lycarter/speakez/png/female no mask.jpg

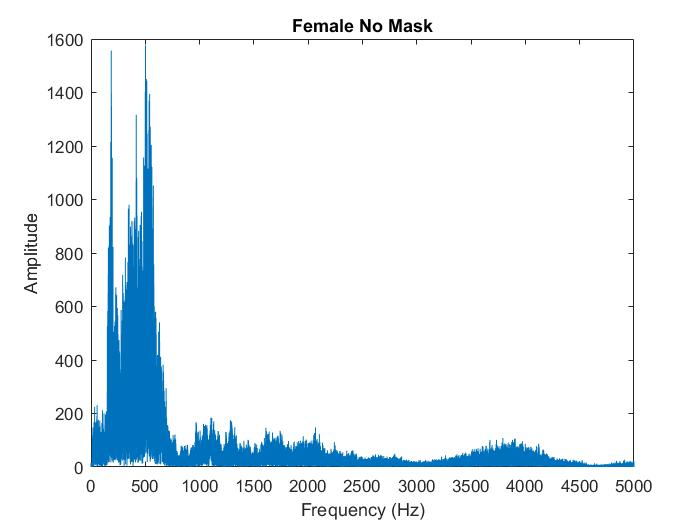
png/female no mask.jpg
