lycarter/speakez/png/female with mask.jpg

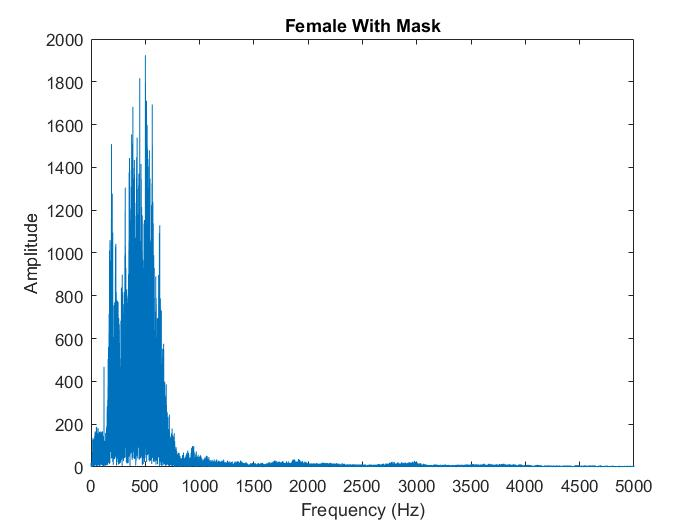
png/female with mask.jpg
