lycarter/speakez/png/fft_comparison.png

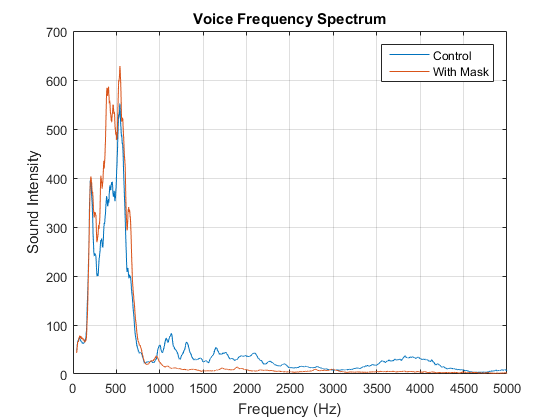
png/fft_comparison.png
