lycarter/speakez/png/fft_comparison_pretty.png

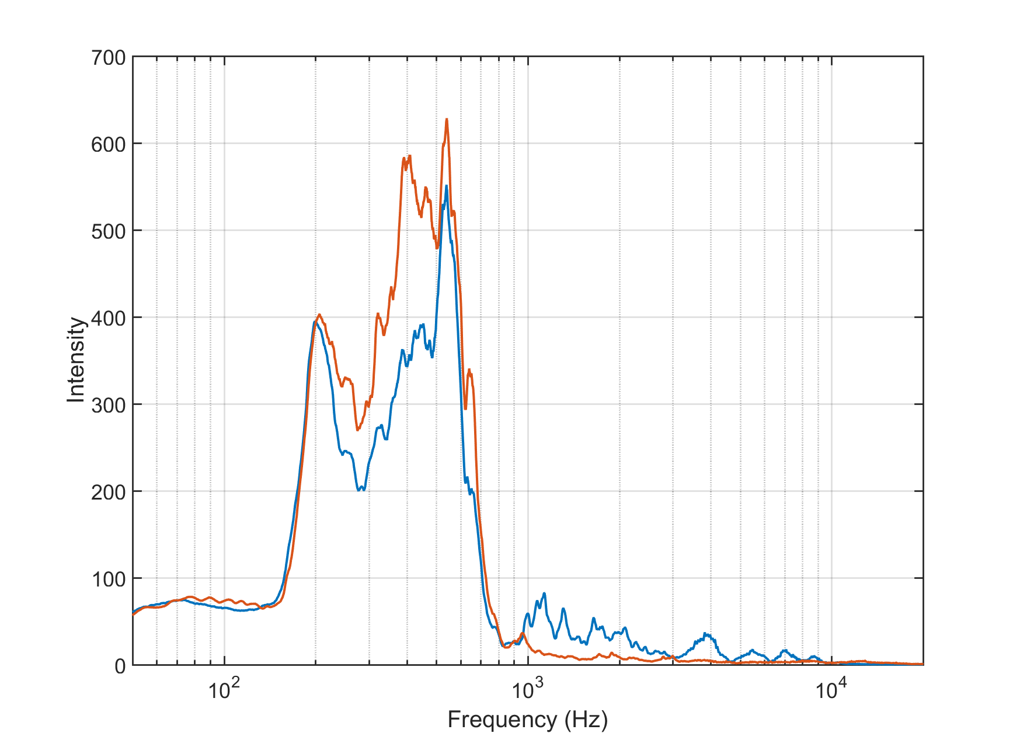
png/fft_comparison_pretty.png
