lycarter/speakez/png/fft_logcompare.png

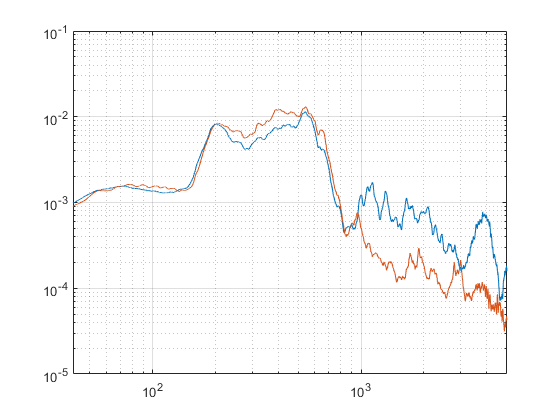
png/fft_logcompare.png
