lycarter/speakez/png/hifreq_output.png

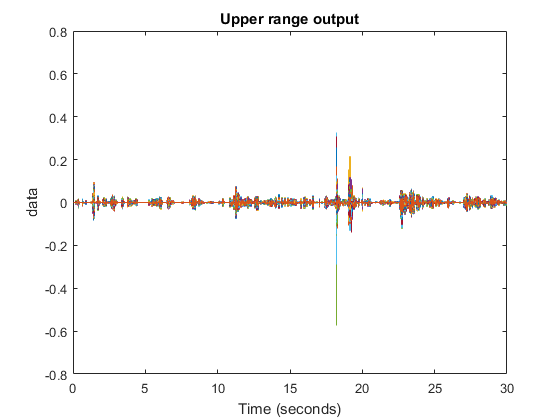
png/hifreq_output.png
