lycarter/speakez/png/input.png

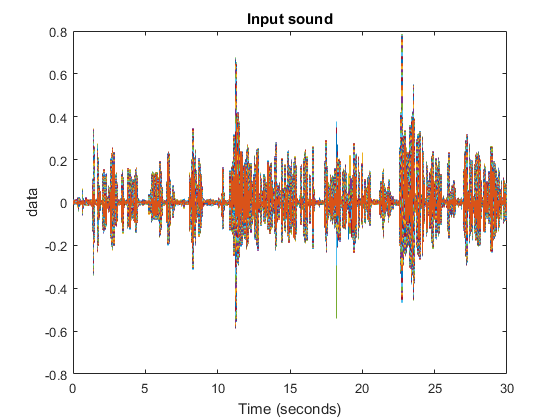
png/input.png
