lycarter/speakez/png/lofreq_output.png

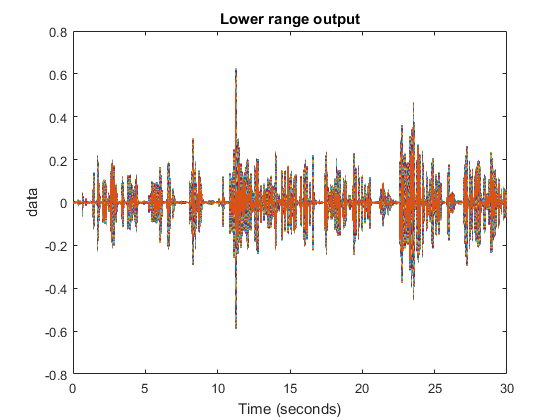
png/lofreq_output.png
