lycarter/speakez/png/mask_tf.png

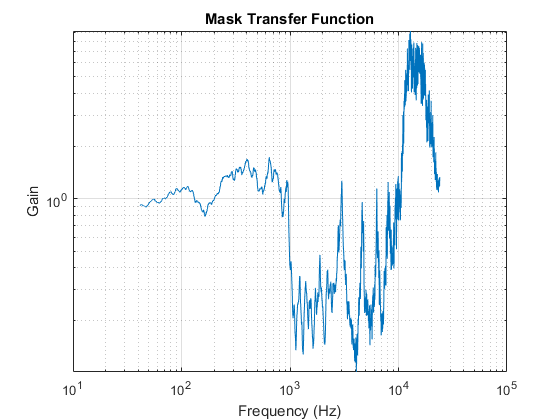
png/mask_tf.png
