lycarter/speakez/png/mask_tf_pretty.png

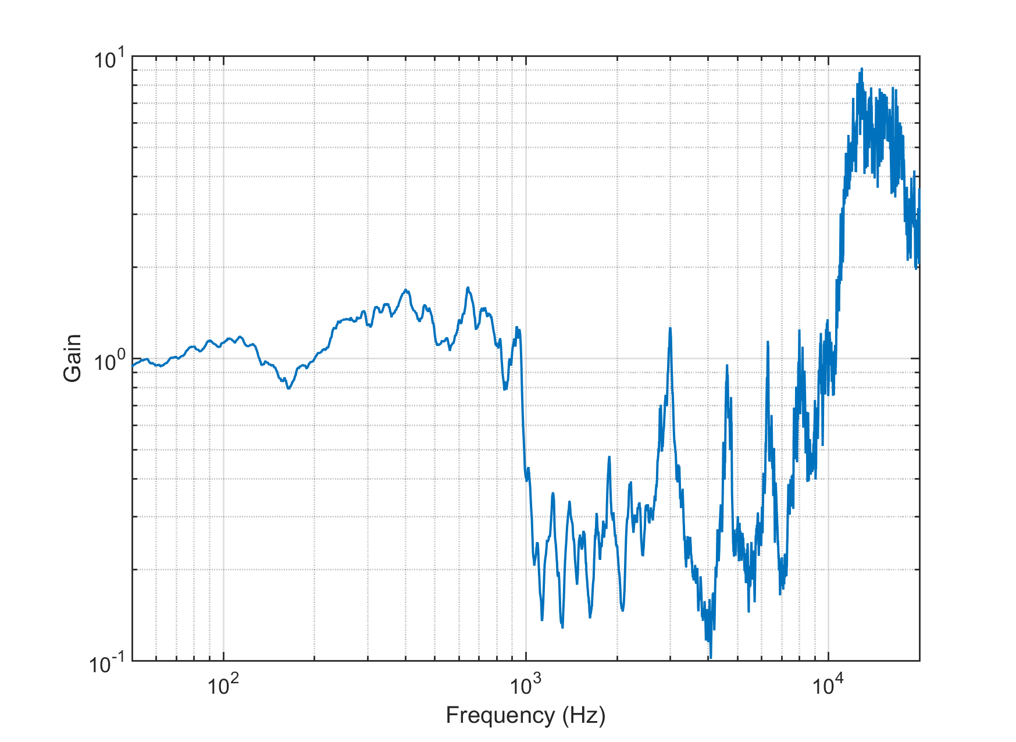
png/mask_tf_pretty.png
