lycarter/speakez/png/no mask divided by mask.jpg

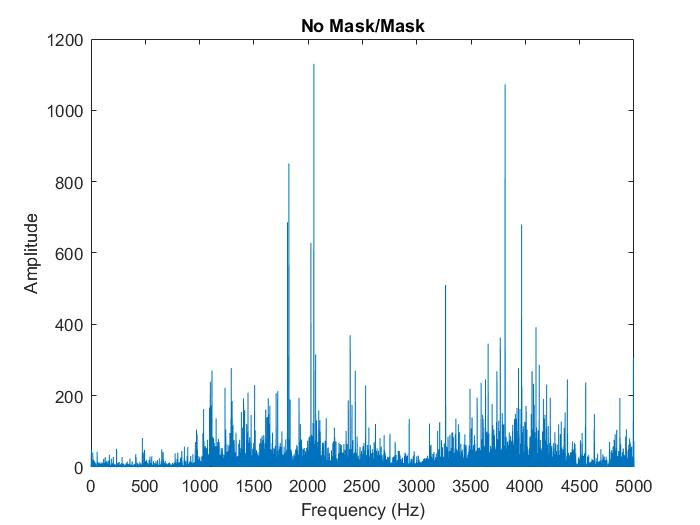
png/no mask divided by mask.jpg
