lycarter/speakez/eagle/speakez/analog-only/analog_v10.brd

## EAGLE design eagle/speakez/analog-only/analog_v10.brd (2016-12-03)

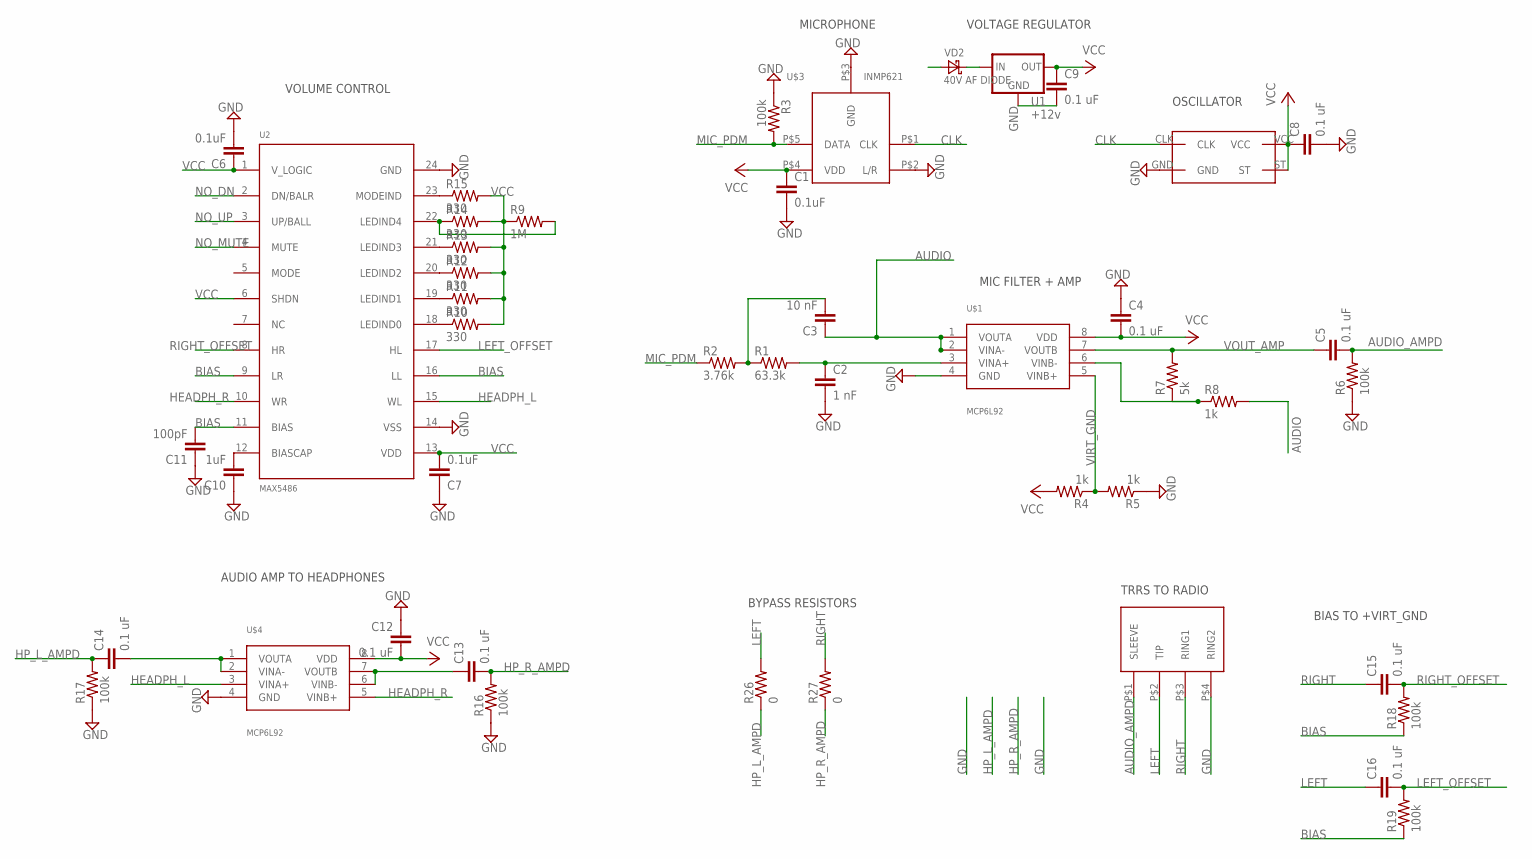
[picture p12: schematic analog_v10.sch]

Parts:
C1, C6, C7: 0.1uF; 0805
C2: 1 nF; 0805
C3: 10 nF; 0805
C4, C5, C8, C9, C12, C13, C14, C15, C16: 0.1 uF; 0805
C10: 1uF; 0805
C11: 100pF; 0805
R1: 63.3k; 0805
R2: 3.76k; 0805
R3, R6, R16, R17, R18, R19: 100k; 0805
R4, R5, R8: 1k; 0805
R7: 5k; 0805
R9: 1M; 0805
R10, R11, R12, R13, R14, R15: 330; 0805
R26, R27: 0; 0805
RADIO: SJ-43514-SMT; 35MM_SMD_4WIRE
U1: +12v; TO-252
U2: MAX5486; TSSOP24
U$1, U$4: MCP6L92; MSOP8
U$2: SG-210STF
U$3: INMP621; CUSTOM_MIC
VD2: 40V AF DIODE; SOD123

Connections:
AUDIO: C3.1, R8.2, U$1.1 (VOUTA), U$1.2 (VINA-)
AUDIO_AMPD: C5.2, R6.2, RADIO.P$1 (SLEEVE)
BIAS: C11.2, R18.1, R19.1, U2.9 (LR), U2.11 (BIAS), U2.16 (LL)
CLK: U$2.CLK, U$3.P$1 (CLK)
GND: C1.2, C2.2, C4.1, C6.2, C7.1, C8.2, C9.2, C10.1, C11.1, C12.1, R3.1, R5.1, R6.1, R16.1, R17.1, RADIO.P$4 (RING2), U1.3 (GND), U2.14 (VSS), U2.24 (GND), U$1.4 (GND), U$2.GND, U$3.P$2 (L/R), U$3.P$3 (GND), U$4.4 (GND)
HEADPH_L: U2.15 (WL), U$4.3 (VINA+)
HEADPH_R: U2.10 (WR), U$4.5 (VINB+)
HP_L_AMPD: C14.1, R17.2, R26.1
HP_R_AMPD: C13.2, R16.2, R27.1
LEFT: C16.1, R26.2, RADIO.P$2 (TIP)
LEFT_OFFSET: C16.2, R19.2, U2.17 (HL)
MIC_PDM: R2.1, R3.2, U$3.P$5 (DATA)
unnamed: C2.1, R1.2, U$1.3 (VINA+)
unnamed: C3.2, R1.1, R2.2
unnamed: R10.1, U2.18 (LEDIND0)
unnamed: R11.1, U2.19 (LEDIND1)
unnamed: R7.1, R8.1, U$1.6 (VINB-)
unnamed: R12.1, U2.20 (LEDIND2)
unnamed: R13.1, U2.21 (LEDIND3)
unnamed: C13.1, U$4.6 (VINB-), U$4.7 (VOUTB)
unnamed: R15.1, U2.23 (MODEIND)
unnamed: C10.2, U2.12 (BIASCAP)
unnamed: R9.2, R14.1, U2.22 (LEDIND4)
unnamed: C14.2, U$4.1 (VOUTA), U$4.2 (VINA-)
NO_DN: U2.2 (DN/BALR)
NO_MUTE: U2.4 (MUTE)
NO_UP: U2.3 (UP/BALL)
RIGHT: C15.1, R27.2, RADIO.P$3 (RING1)
RIGHT_OFFSET: C15.2, R18.2, U2.8 (HR)
VBAT: VD2.A
VBATSAFE: U1.2 (IN), VD2.C
VCC: C1.1, C4.2, C6.1, C7.2, C8.1, C9.1, C12.2, R4.2, R9.1, R10.2, R11.2, R12.2, R13.2, R14.2, R15.2, U1.1 (OUT), U2.1 (V_LOGIC), U2.6 (SHDN), U2.13 (VDD), U$1.8 (VDD), U$2.ST, U$2.VCC, U$3.P$4 (VDD), U$4.8 (VDD)
VIRT_GND: R4.1, R5.2, U$1.5 (VINB+)
VOUT_AMP: C5.1, R7.2, U$1.7 (VOUTB)

Notes on the sheet:
TRRS TO RADIO
BYPASS RESISTORS
AUDIO AMP TO HEADPHONES
VOLUME CONTROL
MIC FILTER + AMP
OSCILLATOR
MICROPHONE
VOLTAGE REGULATOR
BIAS TO +VIRT_GND

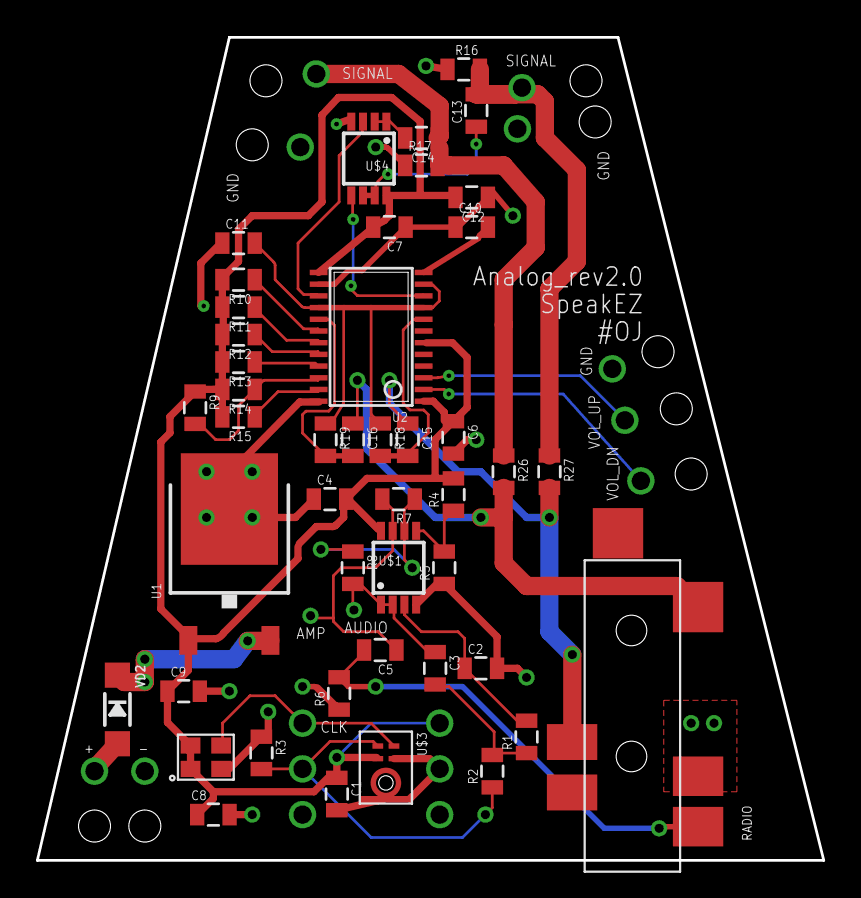
[picture p13: board analog_v10.brd from above]

Board: 2 copper layers, 43.7 x 45.7 mm, 45 parts (0 on the bottom side), 30 nets.
