lycarter/speakez/eagle/speakez/mainboard.brd

## EAGLE design eagle/speakez/mainboard.brd (2016-11-14)

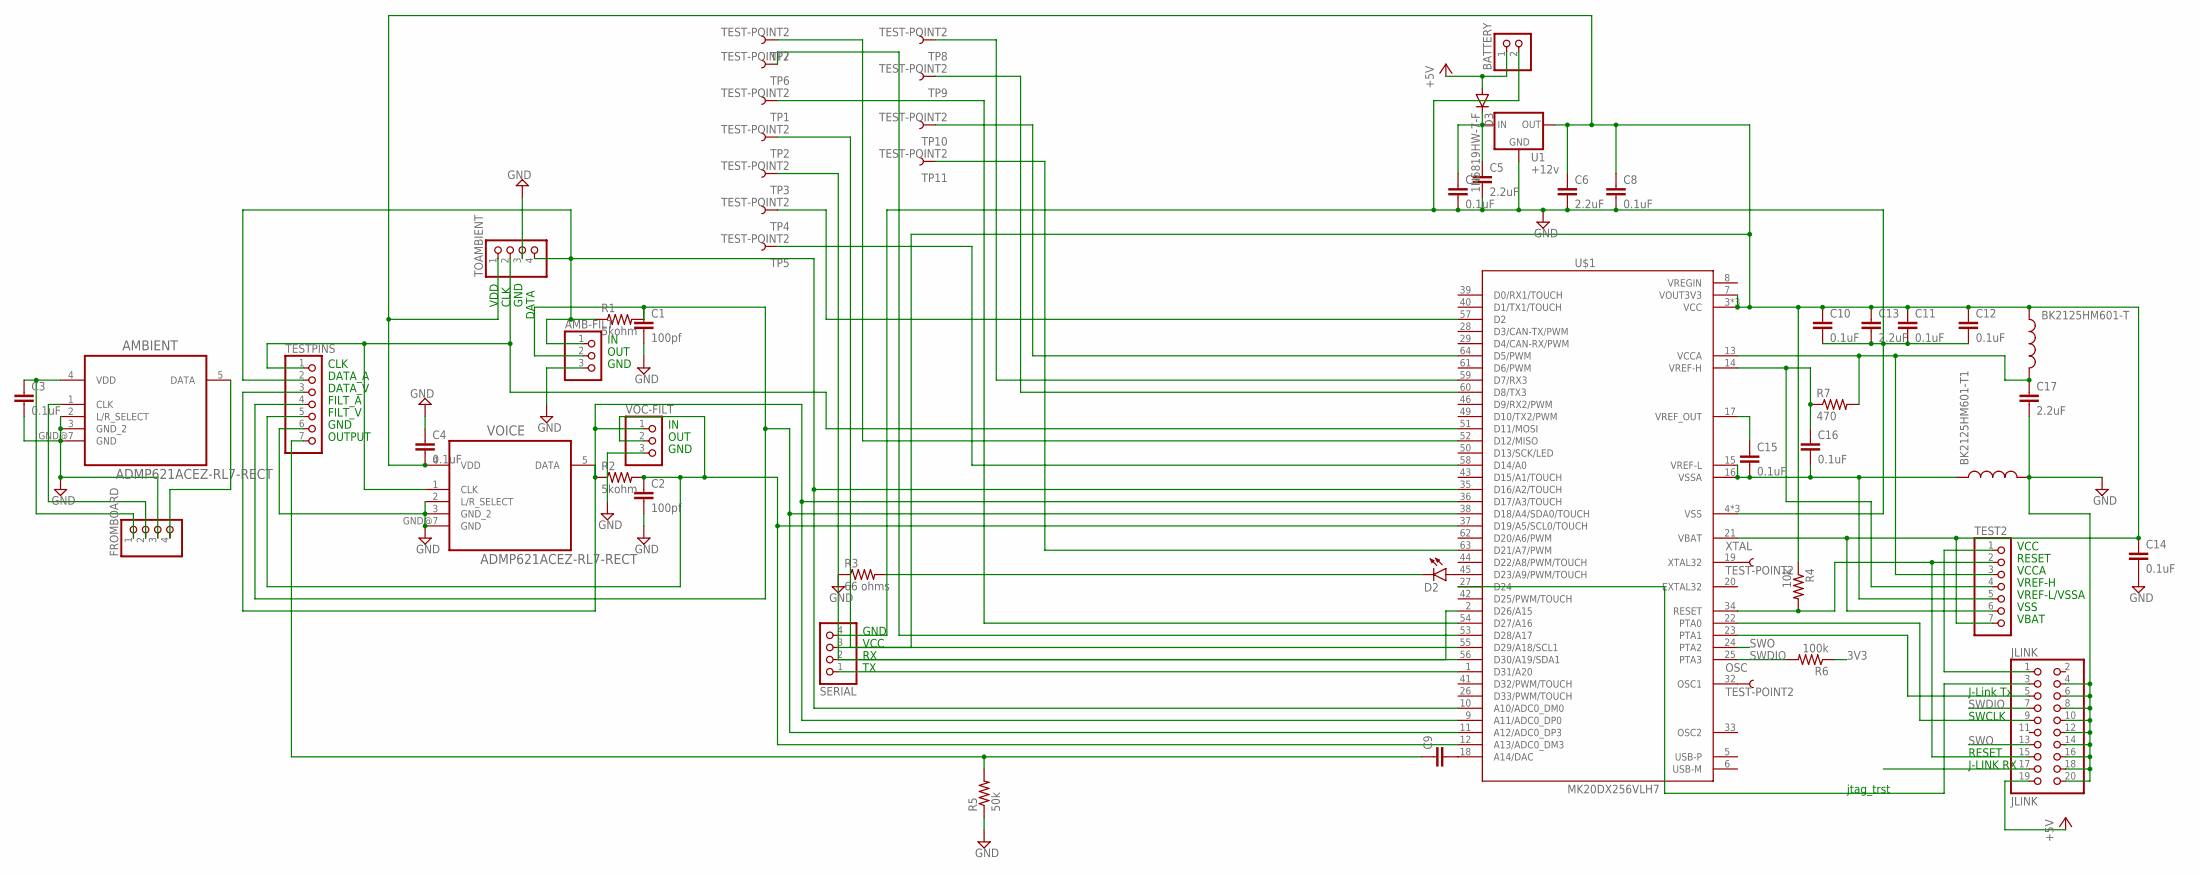
[picture p14: schematic mainboard.sch]

Parts:
AMB-FILT: PINHD-1X3; 1X03
AMBIENT: ADMP621ACEZ-RL7-RECT
BATTERY: PINHD-1X2; 1X02
BK2125HM601-T, BK2125HM601-T1: INDUCTOR0805; 0805
C1, C2: 100pf; 0805
C3, C4, C7, C8, C10, C11, C12, C14, C15, C16: 0.1uF; 0805
C5, C6, C13, C17: 2.2uF; 0805
C9: CAP0805; 0805
D2: LED1206; LED-1206
D3: 1N5819HW-7-F; SOD-123
FROMBOARD: PINHD-1X4; 1X04
JLINK: JLINK; 2X10
OSC: TEST-POINT2; PAD.02X.02
R1, R2: 5kohm; 0805
R3: 66 ohms; 0805
R4: 10k; 0805
R5: 50k; 0805
R6: 100k; 0805
R7: 470; 0805
SERIAL: PINHD-1X4; 1X04
TEST2: PINHD-1X7; 1X07
TESTPINS: PINHD-1X7; 1X07
TOAMBIENT: PINHD-1X4M; 1X04M
TP1, TP2, TP3, TP4, TP5, TP6, TP7, TP8, TP9, TP10, TP11: TEST-POINT2; PAD.02X.02
U1: +12v; TO-252
U$1: MK20DX256VLH7; QFP50P1200X1200X160-64N
VOC-FILT: PINHD-1X3; 1X03
VOICE: ADMP621ACEZ-RL7-RECT
XTAL: TEST-POINT2; PAD.02X.02

Connections:
3V3: R6.1
+5V: BATTERY.1, D3.A, JLINK.19
CLK: TESTPINS.1, TOAMBIENT.2, U$1.51 (D11/MOSI), VOICE.1 (CLK)
CLK2-A: AMBIENT.1 (CLK), FROMBOARD.2
DATA: R2.1, TESTPINS.3, U$1.9 (A11/ADC0_DP0), U$1.36 (D17/A3/TOUCH), VOC-FILT.1, VOICE.5 (DATA)
DATA2: AMB-FILT.1, R1.1, TESTPINS.2, TOAMBIENT.4, U$1.10 (A10/ADC0_DM0), U$1.35 (D16/A2/TOUCH)
DATA2-A: AMBIENT.5 (DATA), FROMBOARD.4
GND: AMB-FILT.3, AMBIENT.2 (L/R_SELECT), AMBIENT.3 (GND_2), AMBIENT.GND@7 (GND), BATTERY.2, BK2125HM601-T1.2, C1.2, C2.2, C3.2, C4.1, C5.2, C6.2, C7.2, C8.2, C10.2, C11.2, C12.2, C13.2, C14.2, C17.2, FROMBOARD.3, JLINK.4, JLINK.6, JLINK.8, JLINK.10, JLINK.12, JLINK.14, JLINK.16, JLINK.18, JLINK.20, R3.1, R5.1, SERIAL.4, TESTPINS.6, TOAMBIENT.3, U1.3 (GND), U$1.4 (VSS), U$1.31 (VSS), U$1.47 (VSS), VOC-FILT.3, VOICE.2 (L/R_SELECT), VOICE.3 (GND_2), VOICE.GND@7 (GND)
JTAG_TRST: JLINK.3, U$1.27 (D24)
unnamed: AMB-FILT.2, C1.1, R1.2, TESTPINS.4, U$1.11 (A12/ADC0_DP3), U$1.38 (D18/A4/SDA0/TOUCH)
unnamed: C2.1, R2.2, TESTPINS.5, U$1.12 (A13/ADC0_DM3), U$1.37 (D19/A5/SCL0/TOUCH), VOC-FILT.2
unnamed: TP7.P$1, U$1.52 (D12/MISO)
unnamed: TP6.P$1, U$1.53 (D28/A17)
unnamed: TP1.P$1, U$1.54 (D27/A16)
unnamed: TP2.P$1, U$1.55 (D29/A18/SCL1)
unnamed: TP3.P$1, U$1.56 (D30/A19/SDA1)
unnamed: TP4.P$1, U$1.57 (D2)
unnamed: TP5.P$1, U$1.58 (D14/A0)
unnamed: TP8.P$1, U$1.59 (D7/RX3)
unnamed: TP9.P$1, U$1.60 (D8/TX3)
unnamed: JLINK.5, U$1.23 (PTA1)
unnamed: JLINK.9, U$1.22 (PTA0)
unnamed: C5.1, C7.1, D3.C, U1.2 (IN)
unnamed: JLINK.1, TEST2.1
unnamed: D2.A, U$1.45 (D23/A9/PWM/TOUCH)
unnamed: TP10.P$1, U$1.64 (D5/PWM)
unnamed: D2.C, R3.2
unnamed: BK2125HM601-T1.1, C15.2, C16.2, TEST2.5, U$1.15 (VREF-L), U$1.16 (VSSA)
unnamed: TP11.P$1, U$1.63 (D21/A7/PWM)
unnamed: C16.1, R7.1, TEST2.4, U$1.14 (VREF-H)
unnamed: U$1.19 (XTAL32), XTAL.P$1
unnamed: SERIAL.1, U$1.1 (D31/A20)
unnamed: SERIAL.2, U$1.2 (D26/A15)
unnamed: C9.2, U$1.18 (A14/DAC)
unnamed: C9.1, R5.2, TESTPINS.7
unnamed: OSC.P$1, U$1.32 (OSC1)
unnamed: BK2125HM601-T.2, C17.1, R7.2, TEST2.3, U$1.13 (VCCA)
unnamed: C15.1, U$1.17 (VREF_OUT)
RESET: JLINK.15, R4.2, TEST2.2, U$1.34 (RESET)
SWDIO: JLINK.7, R6.2, U$1.25 (PTA3)
SWO: JLINK.13, U$1.24 (PTA2)
VDD-DECOUP: BK2125HM601-T.1, C4.2, C6.1, C8.1, C10.1, C11.1, C12.1, C13.1, C14.1, R4.1, SERIAL.3, TEST2.6, TEST2.7, TOAMBIENT.1, U1.1 (OUT), U$1.3 (VCC), U$1.7 (VOUT3V3), U$1.21 (VBAT), U$1.30 (VCC), U$1.48 (VCC), VOICE.4 (VDD)
VDD-DECOUP-A: AMBIENT.4 (VDD), C3.1, FROMBOARD.1

Notes on the sheet:
VDD
DATA
GND
CLK
VCC
DATA_A
DATA_V
FILT_A
FILT_V
OUTPUT
RESET
VCCA
VREF-H
VREF-L/VSSA
VBAT
VSS
J-Link Tx
SWCLK
J-LINK RX
jtag_trst
OUT

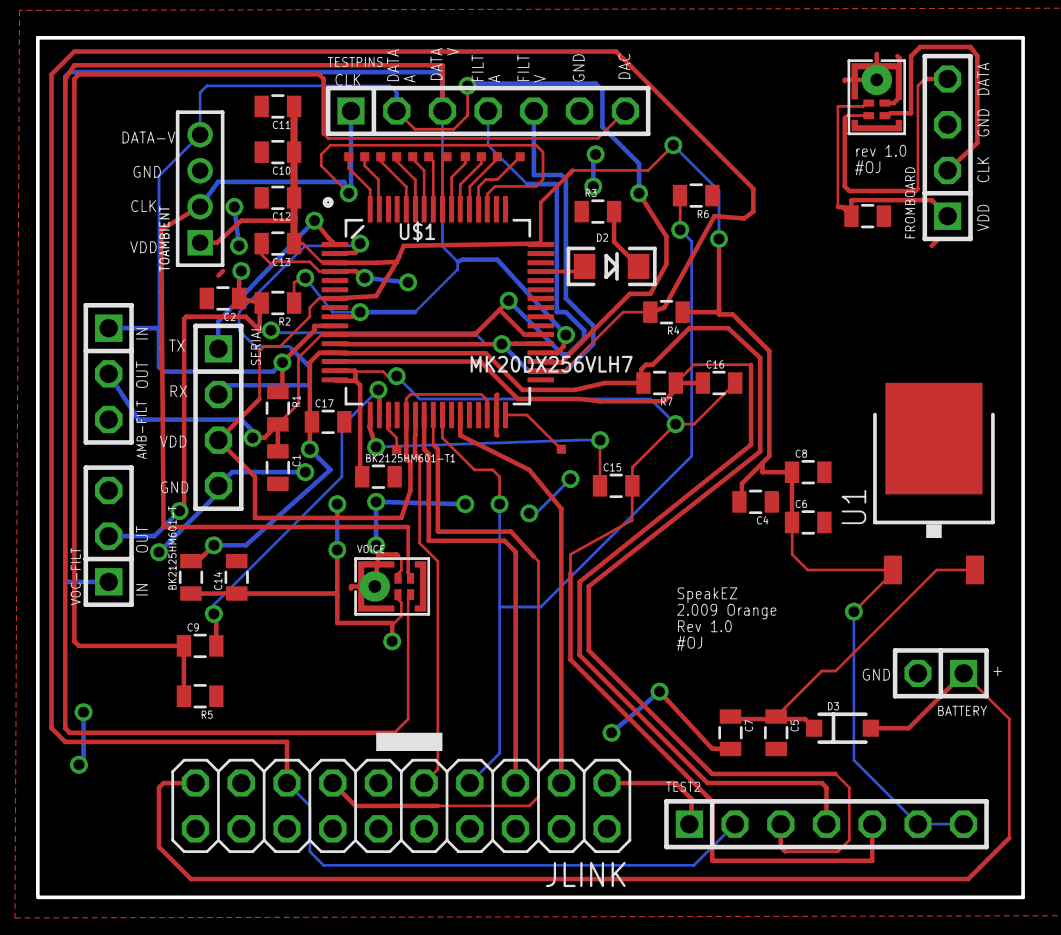
[picture p15: board mainboard.brd from above]

Board: 2 copper layers, 54.7 x 47.8 mm, 54 parts (0 on the bottom side), 42 nets.
