lycarter/speakez/eagle/Custom-Teensy-master/Custom_Teensy_3.1.brd

## EAGLE design eagle/Custom-Teensy-master/Custom_Teensy_3.1.brd (2016-11-14)

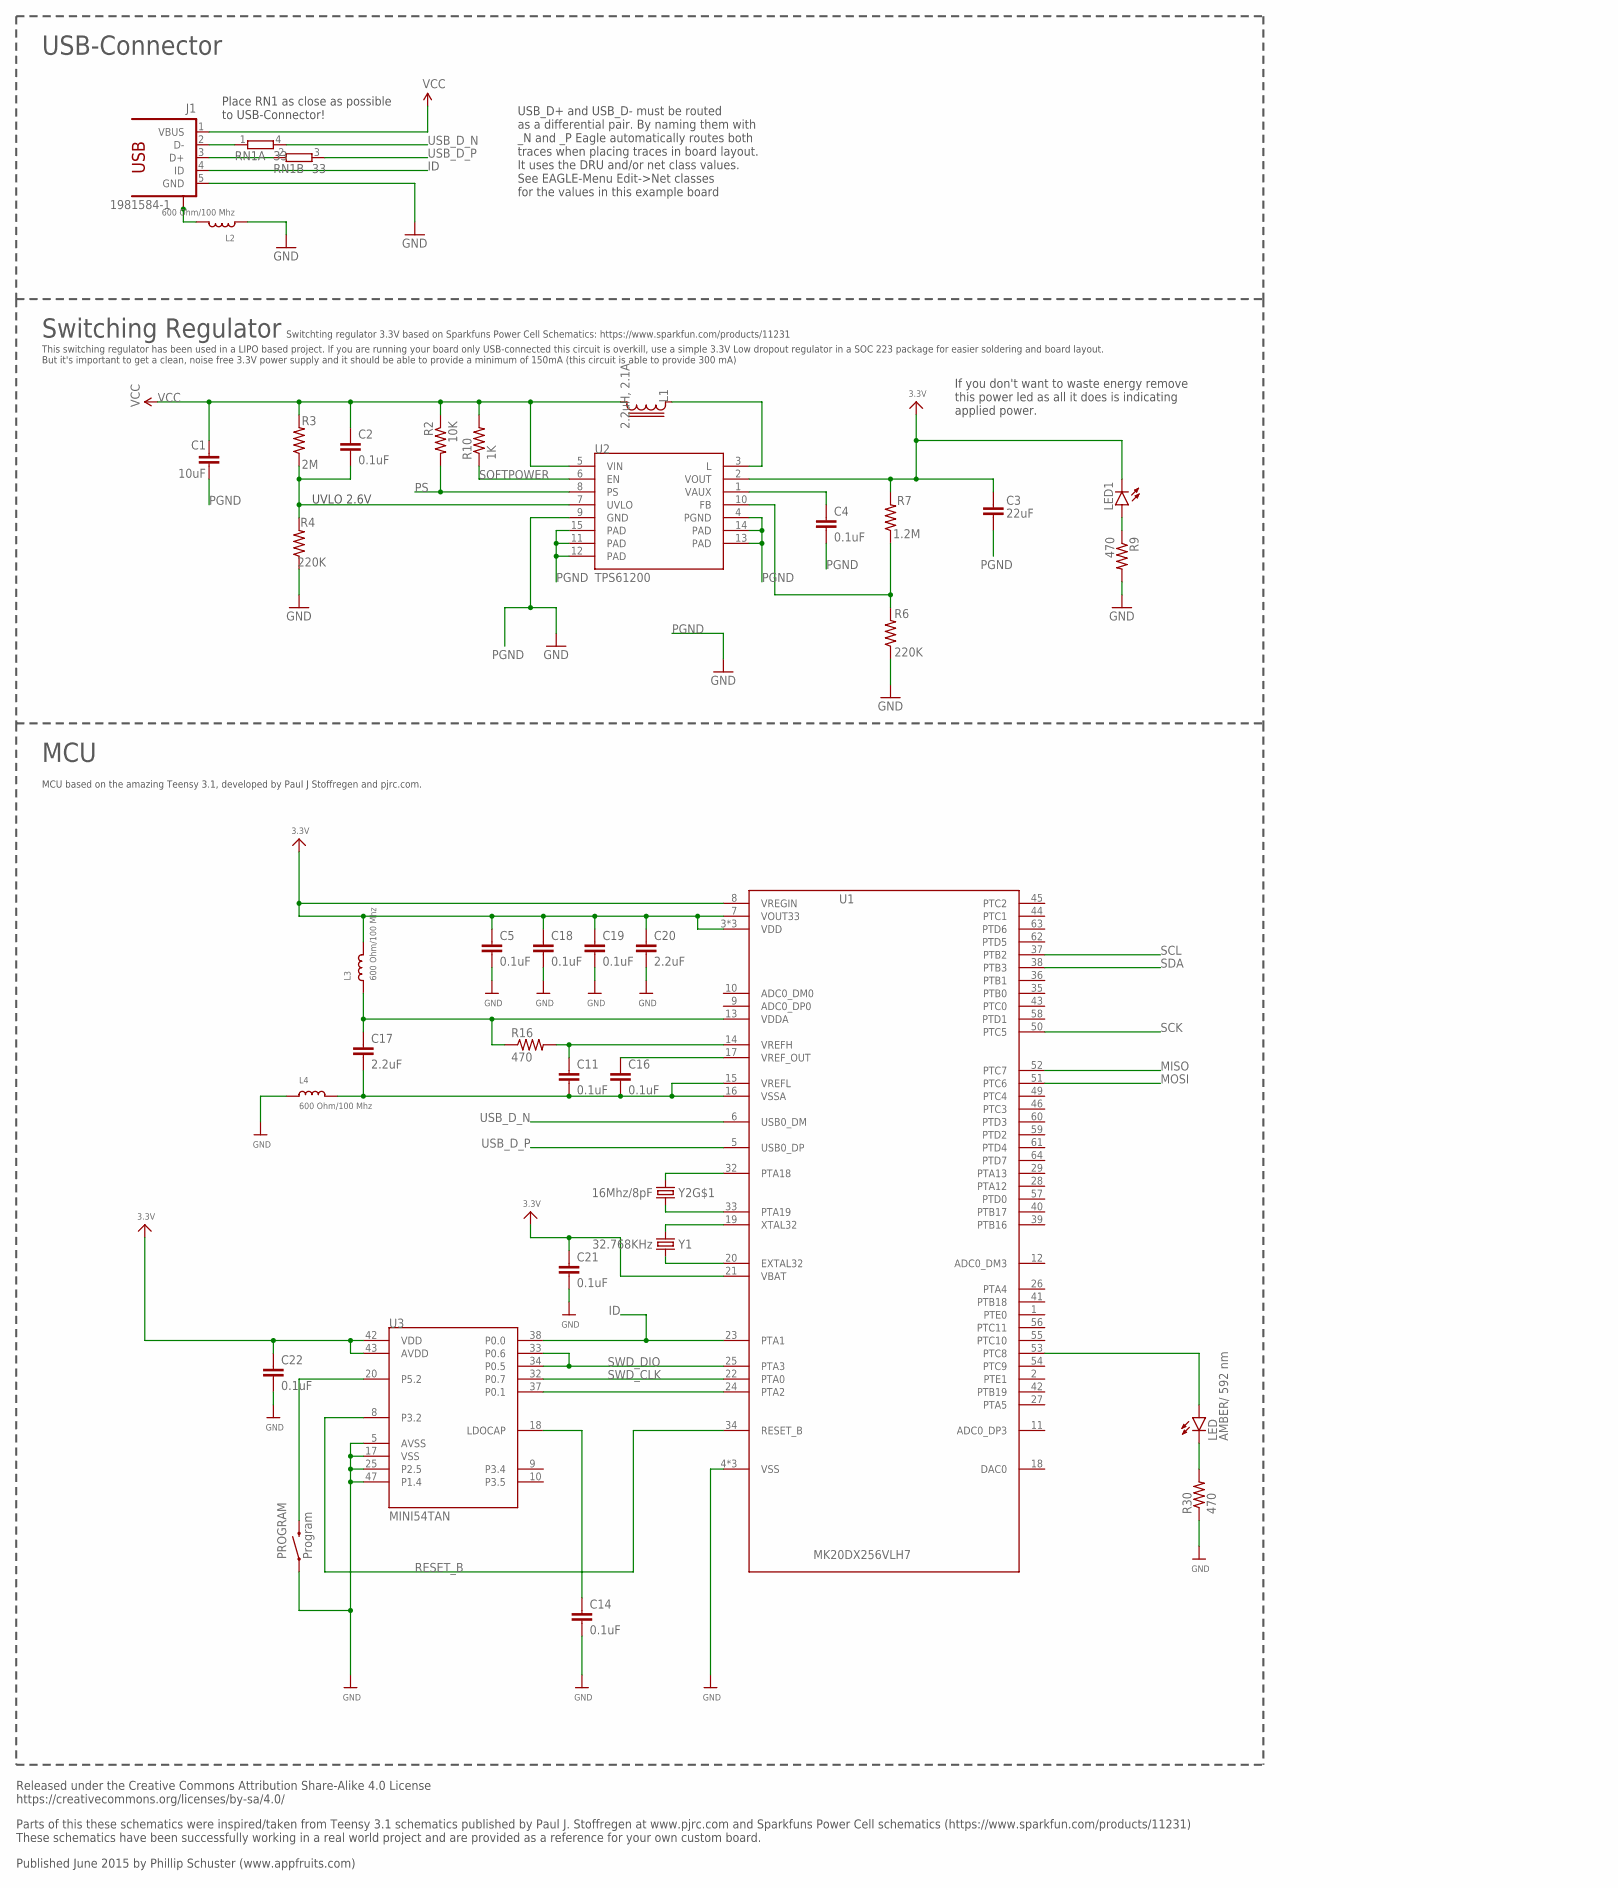
[picture p16: schematic Custom_Teensy_3.1.sch]

Parts:
C1: 10uF; 0603-CAP
C2, C4, C5, C11, C14, C16, C18, C19, C21, C22: 0.1uF; 0603-CAP
C3: 22uF; 0603-CAP
C17, C20: 2.2uF; 0603-CAP
J1: 1981584-1; MPN ZX62-AB-5PA(11)
L1: 2.2uH, 2.1A; LPS3015
L2, L3, L4: 600 Ohm/100 Mhz; 0805
LED: AMBER/ 592 nm; LED-0603
LED1: LED-GREEN; LED-0603
PROGRAM: Program; TACTILE-SWITCH-1101NE; MPN RS-282G05A3-SM RT
R2: 10K; 0603-RES
R3: 2M; 0603-RES
R4, R6: 220K; 0603-RES
R7: 1.2M; 0603-RES
R9, R16, R30: 470; 0603-RES
R10: 1K; 0603-RES
RN1: 33; EXB34V; MPN EXB-34V330JV
U1: MK20DX256VLH7; MPN MK20DX256VLH7
U2: TPS61200; QFN-10_PAD
U3: MINI54TAN
Y1: 32.768KHz; CRYSTAL-TXC-7A; MPN FC-255 32.7680K-A3
Y2: 16Mhz/8pF; CRYSTAL-SMD-5X3; MPN ECS-160-8-30B-CKM

Connections:
3.3V: C3.1, C5.1, C18.1, C19.1, C20.1, C21.1, C22.1, L3.2, LED1.C, R7.2, U1.3 (VDD), U1.7 (VOUT33), U1.8 (VREGIN), U1.21 (VBAT), U1.30 (VDD), U1.48 (VDD), U2.2 (VOUT), U3.42 (VDD), U3.43 (AVDD)
FB: R6.2, R7.1, U2.10 (FB)
GND: C5.2, C14.2, C18.2, C19.2, C20.2, C21.2, C22.2, J1.5 (GND), L2.1, L4.1, PROGRAM.P$1 (1), R4.1, R6.1, R9.2, R30.1, U1.4 (VSS), U1.31 (VSS), U1.47 (VSS), U3.5 (AVSS), U3.17 (VSS), U3.25 (P2.5), U3.47 (P1.4)
ID: J1.4 (ID), U1.23 (PTA1), U3.38 (P0.0)
MISO: U1.52 (PTC7)
MOSI: U1.51 (PTC6)
unnamed: LED1.A, R9.1
unnamed: L1.1, U2.3 (L)
unnamed: LED.A, U1.53 (PTC8)
unnamed: U1.24 (PTA2), U3.37 (P0.1)
unnamed: LED.C, R30.2
unnamed: PROGRAM.P$2 (2), U3.20 (P5.2)
unnamed: C14.1, U3.18 (LDOCAP)
unnamed: U1.32 (PTA18), Y2.3 (2)
unnamed: U1.33 (PTA19), Y2.1
unnamed: U1.19 (XTAL32), Y1.P$2 (2)
unnamed: U1.20 (EXTAL32), Y1.P$1 (1)
PGND: C1.2, C3.2, C4.2, U2.4 (PGND), U2.9 (GND), U2.11 (PAD), U2.12 (PAD), U2.13 (PAD), U2.14 (PAD), U2.15 (PAD)
PS: R2.2, U2.8 (PS)
RESET_B: U1.34 (RESET_B), U3.8 (P3.2)
SCK: U1.50 (PTC5)
SCL: U1.37 (PTB2)
SDA: U1.38 (PTB3)
SOFTPOWER: R10.1, U2.6 (EN)
SWD_CLK: U1.22 (PTA0), U3.32 (P0.7)
SWD_DIO: U1.25 (PTA3), U3.33 (P0.6), U3.34 (P0.5)
USB_CON_N: J1.2 (D-), RN1.1
USB_CON_P: J1.3 (D+), RN1.2 (1)
USB_D_N: RN1.4 (2), U1.6 (USB0_DM)
USB_D_P: RN1.3 (2), U1.5 (USB0_DP)
USB_SHIELD: J1.S1, J1.S2, J1.S3, J1.S4, L2.2
UVLO: C2.2, R3.1, R4.2, U2.7 (UVLO)
VAUX: C4.1, U2.1 (VAUX)
VCC: C1.1, C2.1, J1.1 (VBUS), L1.2, R2.1, R3.2, R10.2, U2.5 (VIN)
VDDA: C17.1, L3.1, R16.1, U1.13 (VDDA)
VREFH: C11.1, R16.2, U1.14 (VREFH)
VREFL: C11.2, C16.2, C17.2, L4.2, U1.15 (VREFL), U1.16 (VSSA)
VREF_OUT: C16.1, U1.17 (VREF_OUT)

Notes on the sheet:
UVLO 2.6V
USB-Connector
Switching Regulator
MCU
MCU based on the amazing Teensy 3.1, developed by Paul J Stoffregen and pjrc.com.
Place RN1 as close as possible to USB-Connector!
If you don't want to waste energy remove this power led as all it does is indicating applied power.
USB_D+ and USB_D- must be routed as a differential pair. By naming them with _N and _P Eagle automatically routes both traces when placing traces in board layout. It uses the DRU and/or net class values. See EAGLE-Menu Edit->Net classes for the values in this example board
Released under the Creative Commons Attribution Share-Alike 4.0 License https://creativecommons.org/licenses/by-sa/4.0/
Parts of this these schematics were inspired/taken from Teensy 3.1 schematics published by Paul J. Stoffregen at www.pjrc.com and Sparkfuns Power Cell schematics (https://www.sparkfun.com/products/11231) These schematics have been successfully working in a real world project and are provided as a r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
Published June 2015 by Phillip Schuster (www.appfruits.com)
Switchting regulator 3.3V based on Sparkfuns Power Cell Schematics: https://www.sparkfun.com/products/11231
This switching regulator has been used in a LIPO based project. If you are running your board only USB-connected this circuit is overkill, use a simple 3.3V Low dropout regulator in a SOC 223 package for easier soldering and board layout. But it's important to get a clean, noise free 3.3V power sup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

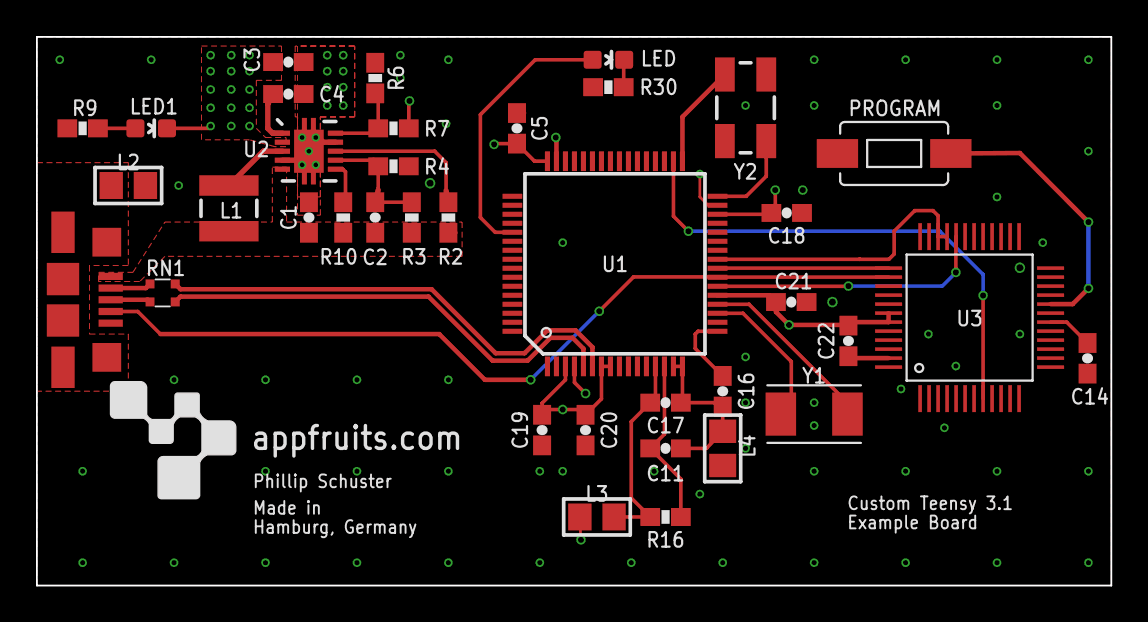
[picture p17: board Custom_Teensy_3.1.brd from above]

Board: 4 copper layers, 59.7 x 30.5 mm, 37 parts (0 on the bottom side), 33 nets.
