lycarter/speakez/(commit log)

2016-11-04 initial commit
    files from assembly review
2016-11-05 add eagle project
    empty project/schematic
    [mainboard.sch]
2016-11-05 add rc circuit to schematic
    [mainboard.sch]
2016-11-05 correct capcitor value
    100pf for rc circuit, 0.1uf for decoupling cap
    [mainboard.sch]
2016-11-05 added mics and breakout pins
    added both mics and test pins, also female pins for attaching teensy
    (remove if you were planning to just use a breadboard)
    [mainboard.sch]
2016-11-05 Ribbon cable
    we were going to use a ribbon cable I think? I added headers for that
    [mainboard.sch]
2016-11-06 change mic cap value, add battery header
    Changed mic cap to datasheet recommendation. Added screw terminals for
    battery + diode for protection
    [mainboard.sch]
2016-11-06 Added board
    Added board, still needs to be routed
    [mainboard.brd]
2016-11-06 Added GND to test pins
    [mainboard.brd, mainboard.sch]
2016-11-06 Added decoupling cap
    [mainboard.brd, mainboard.sch]
2016-11-06 Merge remote-tracking branch 'origin/master'
    # Conflicts:
    # eagle/speakez/mainboard.brd
    # eagle/speakez/mainboard.sch
    [mainboard.brd, mainboard.sch]
2016-11-06 added decoupling cap to mic
    also kept clock pin as pin 11
    [mainboard.brd, mainboard.sch]
2016-11-06 remap teensy pins
    move analog inputs to adc pins, switch 3.3v source, gnd source. add clk
    signal to digital output pin
    [mainboard.brd, mainboard.sch]
2016-11-07 Added microcontroller
    [mainboard.brd, mainboard.sch]
2016-11-07 Added battery stuff
    decoupling caps for battery with Fiona
    [mainboard.brd, mainboard.sch]
2016-11-07 Added clock pin
    Still need to connect up headers but I can do that later
    [mainboard.brd, mainboard.sch]
2016-11-07 changed clock
    [mainboard.brd, mainboard.sch]
2016-11-07 disconnected battery from V3v3
    [mainboard.brd, mainboard.sch]
2016-11-07 changed clock pin
    [mainboard.brd, mainboard.sch]
2016-11-07 switched mic in to analog pins
    [mainboard.brd, mainboard.sch]
2016-11-07 added 0.1uF caps
    [mainboard.brd, mainboard.sch]
2016-11-07 re-added the differential pins
    [mainboard.brd, mainboard.sch]
2016-11-07 connect VREFH and VBAT
    [mainboard.brd, mainboard.sch]
2016-11-07 Added test LED
    [mainboard.brd, mainboard.sch]
2016-11-07 added pull-up resistor to RESET
    [mainboard.brd, mainboard.sch]
2016-11-07 added programmer for header
    [mainboard.brd, mainboard.sch]
2016-11-07 added serial header connected to TX/RX
    [mainboard.brd, mainboard.sch]
2016-11-07 added DAC cap + resistor
    didn't choose cap value yet. Sent output to a header test pin
    [mainboard.brd, mainboard.sch]
2016-11-07 test pins for VCC and RESET
    [mainboard.brd, mainboard.sch]
2016-11-07 Custom Teensy
    files from guy who made his own teensy
    [Custom_Teensy_3.1.brd, Custom_Teensy_3.1.csv, Custom_Teensy_3.1.sch]
2016-11-08 Added correct header for programmer
    [mainboard.brd, mainboard.sch]
2016-11-08 added decoupling caps
    to microcontroller VCC pin
    [mainboard.brd, mainboard.sch]
2016-11-08 finished copying over Teensy schematic
    Added a few more caps and ferrite beads to the microcontroller pins. I
    didn't connect VREF-H directly to VBAT. Added test pins.
    [mainboard.brd, mainboard.sch]
2016-11-08 0.05" header to 0.1" header
    [mainboard.brd, mainboard.sch]
2016-11-08 update jlink connector
    also add jtag support
    [mainboard.brd, mainboard.sch]
2016-11-08 started moving things around
    oh god so many passives
    [mainboard.brd]
2016-11-09 added ground rectangle thing
    [mainboard.brd, mainboard.sch]
2016-11-09 added teensy code for analog and digital clocks
2016-11-10 fixed analog write resolution
    [analog_clock.ino, digital_clock.ino]
2016-11-10 added ground plane
    [mainboard.brd, mainboard.sch]
2016-11-10 add serial printouts for the data input pin
2016-11-10 routed some of board
    [mainboard.brd, mainboard.sch]
2016-11-10 update to interrupt-based design
    next step is probably hardware interrupts off the 3mhz clock?
2016-11-10 finished routing board
    Didn't check for overlaps yet. Need to fix mic library.
    [mainboard.brd, mainboard.sch]
2016-11-10 started working on removing overlaps/clearance issues
    still many more to go :grin:
    [mainboard.brd, mainboard.sch]
2016-11-10 tweaked some clearances
    [mainboard.brd]
2016-11-11 fixed lots of clearance issues, added headers for filter testing
    [mainboard.brd, mainboard.sch]
2016-11-11 resolved all conflicts. planning to add silkscreen next
    [mainboard.brd, mainboard.sch]
2016-11-11 corrected battery and voltage regulator
    [mainboard.brd, mainboard.sch]
2016-11-11 board all routed + silkcreening!!! :grin:
    [mainboard.brd, mainboard.sch]
2016-11-11 added board dimensions + output GERBER files
    [mainboard.brd]
2016-11-11 fixed routing to satisfy PCB manufacturer :grimacing:
    [mainboard.brd]
2016-11-11 update board
    add sparkfun libraries
    [mainboard.brd, mainboard.sch]
2016-11-23 start on analog-only, no-subtraction board
    [analog_v10.brd, analog_v10.sch]
2016-11-23 tiny wiring tweak
    [analog_v10.brd, analog_v10.sch]
2016-11-24 Analog Rev 1
    also added a ton of library parts
    [analog_v10.brd, analog_v10.sch]
2016-12-01 Safety diode
    [analog_v10.brd, analog_v10.sch]
2016-12-02 Added headers for mic
    [analog_v10.brd]
2016-12-02 Added new library for volume control
    [analog_v10.brd]
2016-12-02 added volume control
    [analog_v10.brd, analog_v10.sch]
2016-12-02 got rid of LED, now resistors
    [analog_v10.brd, analog_v10.sch]
2016-12-02 added zero ohm resistors...just couldn't resist
    [analog_v10.brd, analog_v10.sch]
2016-12-02 resized board
    [analog_v10.brd, analog_v10.sch]
2016-12-02 all components on, ugly ugly routing
    [analog_v10.brd, analog_v10.sch]
2016-12-02 update L/R buffering, offsets, naming conventions, move info from nets layer to info layer
    [analog_v10.brd, analog_v10.sch]
2016-12-02 routed some of board
    but doubting my routing
    [analog_v10.brd, analog_v10.sch]
2016-12-02 did some more layout, fixed some random things
    [analog_v10.brd, analog_v10.sch]
2016-12-02 made some more progress, shrunk the board
    going to eat breakfast. yay first allnighter of 2.009
    [analog_v10.brd]
2016-12-02 arranged the offsetters
    [analog_v10.brd]
2016-12-02 tweaking things, clearing out some clearance errors
    [analog_v10.brd, analog_v10.sch]
2016-12-02 fixed all clearance issues, unsure about some dimensions issues
    [analog_v10.brd]
2016-12-02 got rid of mute + headphone jack; added solder holes + strain relief
    [analog_v10.brd, analog_v10.sch]
2016-12-02 routing tweaks
    [analog_v10.brd]
2016-12-02 fattened up traces
    [analog_v10.brd]
2016-12-03 few small tweaks, mostly silkscreen modifications. Added gerbers for pcb order
    [analog_v10.brd]
2016-12-03 final tweaks
    [analog_v10.brd, analog_v10.sch]
2016-12-04 add BOM
    [component_BOM.csv]
