lycarter/speakez/(notices)

Notices in the files:
eagle/Custom-Teensy-master/Custom_Teensy_3.1.brd:
to use/see all necessary layers. EAGLEs hobbyist license will do the trick.
parts and their libraries:
SparkFun-Electromechanical: Licensing: Creative Commons ShareAlike 4.0 International - https://creativecommons.org/licenses/by-sa/4.0
con-usb: Copyright (C) 2008, Bob Starr
